eniolaaaa/pet_feeder/board/runtime_stats.c

/*! ***************************************************************************
 *
 * \brief     Functions for generating task run-time statistics
 * \file      runtime_stats.h
 * \author    Hugo Arends
 * \date      March 2024
 *
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
 *****************************************************************************/
#include "runtime_stats.h"

void vConfigureTimerForRunTimeStats( void )
{
    // From section 26.1.5 Initialization (NXP, 2024)
    //
    // 1. Select a clock source for the CTIMER using MRCC_CTIMER0_CLKSEL,
    //    MRCC_CTIMER1_CLKSEL, and MRCC_CTIMER2_CLKSEL registers.
    // 2. Enable the clock to the CTIMER via the
    //    CTIMERGLOBALSTARTEN[CTIMER0_CLK_EN],
    //    CTIMERGLOBALSTARTEN[CTIMER1_CLK_EN], and
    //    CTIMERGLOBALSTARTEN[CTIMER2_CLK_EN] fields. This enables the register
    //    interface and the peripheral function clock.
    // 3. Clear the CTIMER peripheral reset using the MRCC_GLB_RST0 registers.
    // 4. Each CTIMER provides interrupts to the NVIC. See MCR and CCR registers
    //    in the CTIMER register section for match and capture events. For
    //    interrupt connections, see the attached NVIC spreadsheet.
    // 5. Select timer pins and pin modes as needed through the relevant PORT
    //    registers.
    // 6. The CTIMER DMA request lines are connected to the DMA trigger inputs
    //    via the DMAC0_ITRIG_INMUX registers (See Memory map and register
    //    definition). Note that timer DMA request outputs are connected to DMA
    //    trigger inputs.

    // 1.
    //
    // MUX: [101] = CLK_1M
    MRCC0->MRCC_CTIMER2_CLKSEL = MRCC_MRCC_CTIMER2_CLKSEL_MUX(0b101);

    // HALT: [0] = Divider clock is running
    // RESET: [0] = Divider isn't reset
    // DIV: [0000] = divider value = (DIV+1) = 1
    MRCC0->MRCC_CTIMER2_CLKDIV = 0;

    // 2.
    //
    // CTIMER2_CLK_EN: [1] = CTIMER 2 function clock enabled
    SYSCON->CTIMERGLOBALSTARTEN |= SYSCON_CTIMERGLOBALSTARTEN_CTIMER2_CLK_EN(1);

    // 3.
    //
    // Enable modules and leave others unchanged
    // CTIMER2: [1] = Peripheral clock is enabled
    MRCC0->MRCC_GLB_CC0_SET = MRCC_MRCC_GLB_CC0_CTIMER2(1);

    // Release modules from reset and leave others unchanged
    // CTIMER2: [1] = Peripheral is released from reset
    MRCC0->MRCC_GLB_RST0_SET = MRCC_MRCC_GLB_RST0_CTIMER2(1);

    // 4.
    //
    // Specifies the prescale value. 1 MHz / 1000 = 1 kHz
    CTIMER2->PR = 1000-1;

    // 5.
    //
    // Not used.

    // 6.
    //
    // Not used.

    // CEN: [1] = Enables the counters.
    CTIMER2->TCR |= CTIMER_TCR_CEN(1);
}
