eniolaaaa/pet_feeder/starter_backup/rgb.c

/*! ***************************************************************************
 *
 * \brief     RGB LED driver
 * \file      rgb.h
 * \author    Hugo Arends
 * \date      January 2025
 *
 * \see       NXP. (2024). MCX A153, A152, A143, A142 Reference Manual. Rev. 4,
 *            01/2024. From:
 *            https://www.nxp.com/docs/en/reference-manual/MCXAP64M96FS3RM.pdf
 *
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
 *****************************************************************************/
#include "rgb.h"

// -----------------------------------------------------------------------------
// Local type definitions
// -----------------------------------------------------------------------------

// -----------------------------------------------------------------------------
// Local function prototypes
// -----------------------------------------------------------------------------

// -----------------------------------------------------------------------------
// Local variables
// -----------------------------------------------------------------------------

// -----------------------------------------------------------------------------
// Local function implementation
// -----------------------------------------------------------------------------
void rgb_init(void)
{
    // From section 14.3 Functional description (NXP, 2024)
    //
    // Before a module can be used, its clocks must be enabled (CC != 00) and it
    // must be released from reset (MRCC_GLB_RST [peripherals name] = 1). If a
    // module is not released from reset (MRCC_GLB_RST [peripherals name] = 0),
    // an attempt to access a register within that module is terminated with a
    // bus error.

    // Enable modules and leave others unchanged
    // GPIO3: [1] = Peripheral clock is enabled
    // PORT3: [1] = Peripheral clock is enabled
    MRCC0->MRCC_GLB_CC1 |= (1<<8) | (1<<0);

    // Release modules from reset and leave others unchanged
    // GPIO3: [1] = Peripheral is released from reset
    // PORT3: [1] = Peripheral is released from reset
    MRCC0->MRCC_GLB_RST1 |= (1<<8) | (1<<0);

    // From section 11.4 Initialization (NXP, 2024)
    //
    // 1. Initialize the pin functions:
    //    -  Initialize single pin functions by writing appropriate values to
    //       PCRn
    //    -  Initialize multiple pins (up to 16) with the same configuration by
    //       writing appropriate values to Global Pin Control Low (GPCLR) or
    //       Global Pin Control High (GPCHR).
    // 2. Lock the configuration for a given pin, by writing 1 to PCRn [LK], so
    //    that it cannot be changed until the next reset.

    // 1. & 2.
    //
    // Configure P3_0, P3_12 and P3_13
    // LK : [1] = Locks this PCR
    // INV: [0] = Does not invert
    // IBE: [0] = Disables
    // MUX: [0000] = Alternative 0 (GPIO)
    // DSE: [0] = low drive strength is configured on the corresponding pin,
    //            if the pin is configured as a digital output
    // ODE: [0] = Disables
    // SRE: [0] = Fast
    // PE:  [0] = Disables
    // PS:  [0] = n.a.
    PORT3->PCR[0] = 0x00008000;
    PORT3->PCR[12] = 0x00008000;
    PORT3->PCR[13] = 0x00008000;

    // From section 12.5 Initialization (NXP, 2024)
    //
    // 1. Initialize the GPIO pins for the output function:
    //    a. Configure the output logic value for each pin by using Port Data
    //       Output (PDOR).
    //    b. Configure the direction for each pin by using Port Data Direction
    //       (PDDR).
    // 2. Interrupt function not used.

    // 1. a.
    //
    // PDO13, PDO12 and PDO0: [1] = Logic level 1 – LEDs off
    GPIO3->PDOR |= (1<<13) | (1<<12) | (1<<0);

    // 1. b.
    //
    // PDD13, PDO12 and PDO0: [1] = Output
    GPIO3->PDDR |= (1<<13) | (1<<12) | (1<<0);
}

void rgb_red_on(const bool r)
{
    if(r == true)
    {
        GPIO3->PCOR = (1<<12);
    }
    else
    {
        GPIO3->PSOR = (1<<12);
    }
}

void rgb_green_on(const bool g)
{
    if(g == true)
    {
        GPIO3->PCOR = (1<<13);
    }
    else
    {
        GPIO3->PSOR = (1<<13);
    }
}

void rgb_blue_on(const bool b)
{
    if(b == true)
    {
        GPIO3->PCOR = (1<<0);
    }
    else
    {
        GPIO3->PSOR = (1<<0);
    }
}
