eniolaaaa/pet_feeder/(commit log)

2026-10-09 Test scenario 1 on the board, startup HardFault write-up
    Scenario 1 (feed 2 over UART): RTOS-aware debugger screenshots at both
    breakpoints, FeedQ fill level via Watch, console log, comparison and draft
    conclusion. Also documents the startup HardFault found on 2026-10-07
    (CTIMER2 BusFault after clk_lock) and how it was fixed.
2026-10-09 Test scenario 2 on the board: button during a meal
    RTOS-aware debugger screenshots at three stops (Button woken by the ISR,
    request waiting in FeedQ, cooldown rejection), console log, comparison and
    draft conclusion. Documents a real mismatch: one SW3 press bounced for longer
    than the 30 ms debounce and produced three feed requests.
2026-10-09 Button: one request per press, wait for a stable release
    Test scenario 2 showed that SW3 can bounce for longer than the 30 ms
    debounce: one press gave 8 interrupts and 3 feed requests, which filled
    FeedQ. After a request the Button task now polls SW3 every 10 ms until it
    has read released for 30 ms in a row, then drops the collected edges.
    Re-tested on the board; results and log added to scenario 2.
    Flash 26432 B (20%), RAM 18360 B (75%).
2026-10-09 Test scenario 3 on the board: double feeding (fault mode 1)
    RTOS-aware debugger screenshots at both LOG_FED hits, with the Feeder's
    locals in Watch: the button request waits in FeedQ during the scheduled
    meal and starts a second meal at the exact tick the first one ended
    (0 ms gap, today 1/6 -> 2/6). Console log, comparison and draft conclusion.
2026-10-09 Restructure for hand-in: RTOS sources in repo, folders, README
    Study guide gaps:
    - FreeRTOS kernel V11.1.0 copied from the course SDK into rtos/ and built
    by the project's own CMake instead of the SDK component, so the project
    contains all RTOS sources (section 4.1, criterion 3).
    - Sources split into source/ (application) and board/ (hardware layer);
    starter_backup/ removed (still in the initial commit) (criterion 3).
    - README now holds the scheduling, inter-task communication and interrupt
    descriptions, merged from docs/design_README.md (criteria 1 and 2).
    - FreeRTOSConfig.h: every value changed from the course file now has a
    'Pet feeder:' comment with the course value and the rea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
2026-10-09 Design: RAM budget measured on the board
    Fills in the RAM budget TODO: data region use by part, FreeRTOS heap use
    (13 464 B of 14 KB, nothing allocated after start-up) and the stack peak of
    every task from the RTOS-aware debugger and the Monitor task.
2026-10-12 Docs: progress log structure, HardFault reflection draft, stale TODO
    - docs/PROGRESS.md: activity list from the git history, hours left for eni.
    - test_scenarios.md: the 'take the screenshots' TODO is done, replaced by
    how the board evidence was gathered; daily-limit log explained (100 Hz
    tick at the time); draft 'what I learned' for the startup HardFault.
2026-10-12 Project plan filled in; daily-limit test conclusion
    Project plan from eni's answers: student number, LT-coach (Remko Welling),
    motivation, what is new, learning goals, people involved, assessment
    wishes and knowledge sharing. Hand-in and presentation dates still open.
    Daily-limit test: red LED observation and draft conclusion.
2026-10-12 Progress: 4 h from research to debugging; red LED off at NEW DAY
2026-10-12 Design: heartbeat reads the FEEDING bit; debugger view names
    Makes the high-level design match the code exactly (criterion 5): the
    heartbeat timer reads the event group so the green LED doesn't blink
    during a meal.
2026-10-12 Mechanics: 3D printed hopper, gate and base for the SG90 (M4)
    Parametric OpenSCAD model: gravity hopper (~730 ml), swinging gate on the
    SG90 horn, base with gate chamber and servo mount, lid and legs, plus a
    servo test-fit part. README with print settings, assembly and calibration.
