eniolaaaa/pet_feeder/(notices)

Notices in the files:
starter_backup/rgb.c:
\copyright 2025 HAN University of Applied Sciences. All Rights Reserved.
board/runtime_stats.c:
\copyright 2024 HAN University of Applied Sciences. All Rights Reserved.
